ucchimasa/bldc_driver/bldc_driver.kicad_pcb

## KiCad design bldc_driver.kicad_pcb (2026-08-02)

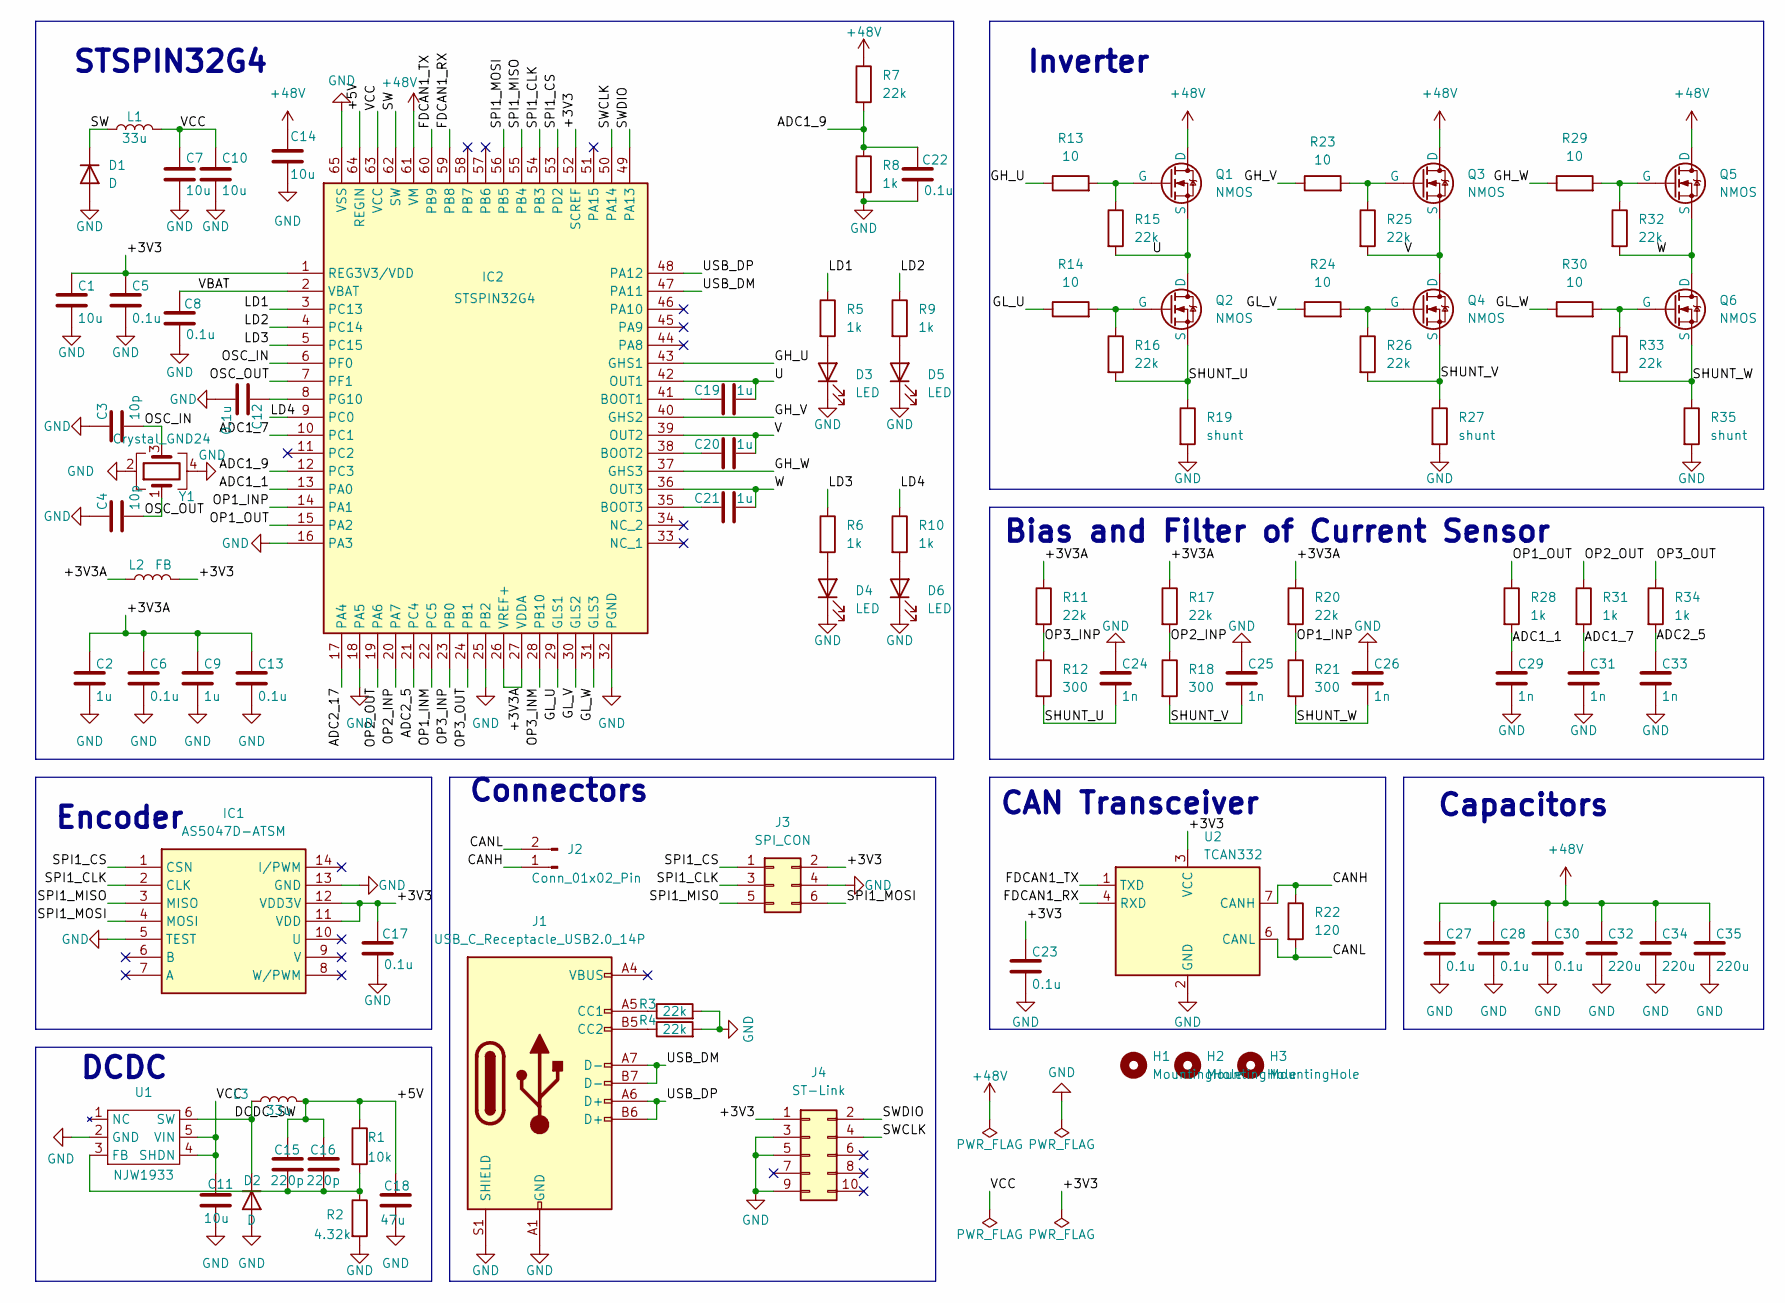
[picture p1: schematic bldc_driver.kicad_sch]

Parts:
C1, C14: 10u; C_1206_3216Metric_Pad1.33x1.80mm_HandSolder
C2, C9, C19, C20, C21: 1u; C_0603_1608Metric_Pad1.08x0.95mm_HandSolder
C3, C4: 10p; C_0603_1608Metric_Pad1.08x0.95mm_HandSolder
C5, C6, C8, C12, C13, C17, C22, C23, C27, C28, C30: 0.1u; C_0603_1608Metric_Pad1.08x0.95mm_HandSolder
C7, C10, C11: 10u; C_0805_2012Metric_Pad1.18x1.45mm_HandSolder
C15, C16: 220p; C_0402_1005Metric_Pad0.74x0.62mm_HandSolder
C18: 47u; C_1210_3225Metric_Pad1.33x2.70mm_HandSolder
C24, C25, C26, C29, C31, C33: 1n; C_0603_1608Metric_Pad1.08x0.95mm_HandSolder
C32, C34, C35: 220u; CP_Elec_10x10
D1, D2: D; RSX101VAM
D3, D4, D5, D6: LED; D_0603_1608Metric_Pad1.05x0.95mm_HandSolder
H1, H2, H3: MountingHole; MountingHole_3.2mm_M3
IC1: AS5047D-ATSM; SOP65P640X120-14N; Mouser Part Number 985-AS5047D-ATSM
IC2: STSPIN32G4; QFN50P900X900X100-65N-D-padlong; Manufacturer_Part_Number STSPIN32G4
J1: USB_C_Receptacle_USB2.0_14P; USB_C_Receptacle_XKB_U262-16XN-4BVC11
J2: Conn_01x02_Pin; PinHeader_1x02_P2.54mm_Vertical
J3: SPI_CON; PinHeader_2x03_P2.54mm_Vertical
J4: ST-Link; PinHeader_2x05_P1.27mm_Vertical_big
L1, L3: 33u; ELL6SH330M
L2: FB; L_0603_1608Metric_Pad1.05x0.95mm_HandSolder
Q1, Q2, Q3, Q4, Q5, Q6: NMOS; SOT8002-1-8
R1: 10k; R_0603_1608Metric_Pad0.98x0.95mm_HandSolder
R2: 4.32k; R_0603_1608Metric_Pad0.98x0.95mm_HandSolder
R3, R4, R7, R11, R15, R16, R17, R20, R25, R26, R32, R33: 22k; R_0603_1608Metric_Pad0.98x0.95mm_HandSolder
R5, R6, R8, R9, R10, R28, R31, R34: 1k; R_0603_1608Metric_Pad0.98x0.95mm_HandSolder
R12, R18, R21: 300; R_0603_1608Metric_Pad0.98x0.95mm_HandSolder
R13, R14, R23, R24, R29, R30: 10; R_0603_1608Metric_Pad0.98x0.95mm_HandSolder
R19, R27, R35: shunt; R_2512_6332Metric_Pad1.40x3.35mm_HandSolder
R22: 120; R_0603_1608Metric_Pad0.98x0.95mm_HandSolder
U1: NJW1933; SOT-23-6-1
U2: TCAN332; SOIC-8_3.9x4.9mm_P1.27mm
Y1: Crystal_GND24; Crystal_SMD_SeikoEpson_FA238V-4Pin_3.2x2.5mm

Connections:
+48V: C14.1, C27.1, C28.1, C30.1, C32.1, C34.1, C35.1, IC2.61 (VM), Q1.1 (D), Q3.1 (D), Q5.1 (D), R7.1
/+3V3: C1.1, C5.1, C17.1, C23.1, IC1.11 (VDD), IC1.12 (VDD3V), IC2.1 (REG3V3/VDD), IC2.52 (SCREF), J3.2, J4.1, L2.2, U2.3 (VCC)
/+3V3A: C2.1, C6.1, C9.1, C13.1, IC2.26 (VREF+), IC2.27 (VDDA), L2.1, R11.1, R17.1, R20.1
/+5V: C15.1, C16.1, C18.1, IC2.64 (REGIN), L3.2, R1.1
/ADC1_1: C29.1, IC2.13 (PA0), R28.2
/ADC1_7: C31.1, IC2.10 (PC1), R31.2
/ADC1_9: C22.1, IC2.12 (PC3), R7.2, R8.1
/ADC2_5: C33.1, IC2.21 (PC4), R34.2
/ADC2_17: IC2.17 (PA4)
/CANH: J2.1, R22.1, U2.7 (CANH)
/CANL: J2.2, R22.2, U2.6 (CANL)
/DCDC_SW: D2.1 (K), L3.1, U1.6 (SW)
/FDCAN1_RX: IC2.59 (PB8), U2.4 (RXD)
/FDCAN1_TX: IC2.60 (PB9), U2.1 (TXD)
/GH_U: IC2.43 (GHS1), R13.1
/GH_V: IC2.40 (GHS2), R23.1
/GH_W: IC2.37 (GHS3), R29.1
/GL_U: IC2.29 (GLS1), R14.1
/GL_V: IC2.30 (GLS2), R24.1
/GL_W: IC2.31 (GLS3), R30.1
/LD1: IC2.3 (PC13), R5.1
/LD2: IC2.4 (PC14), R9.1
/LD3: IC2.5 (PC15), R6.1
/LD4: IC2.9 (PC0), R10.1
/OP1_INM: IC2.22 (PC5)
/OP1_INP: IC2.14 (PA1), R20.2, R21.1
/OP1_OUT: IC2.15 (PA2), R28.1
/OP2_INP: IC2.20 (PA7), R17.2, R18.1
/OP2_OUT: IC2.19 (PA6), R31.1
/OP3_INM: IC2.28 (PB10)
/OP3_INP: IC2.23 (PB0), R11.2, R12.1
/OP3_OUT: IC2.24 (PB1), R34.1
/OSC_IN: C3.2, IC2.6 (PF0), Y1.3
/OSC_OUT: C4.2, IC2.7 (PF1), Y1.1
/SHUNT_U: C24.2, Q2.3 (S), R12.2, R16.2, R19.1
/SHUNT_V: C25.2, Q4.3 (S), R18.2, R26.2, R27.1
/SHUNT_W: C26.2, Q6.3 (S), R21.2, R33.2, R35.1
/SPI1_CLK: IC1.2 (CLK), IC2.54 (PB3), J3.3
/SPI1_CS: IC1.1 (CSN), IC2.53 (PD2), J3.1
/SPI1_MISO: IC1.3 (MISO), IC2.55 (PB4), J3.5
/SPI1_MOSI: IC1.4 (MOSI), IC2.56 (PB5), J3.6
/SW: D1.1 (K), IC2.62 (SW), L1.1
/SWCLK: IC2.50 (PA14), J4.4
/SWDIO: IC2.49 (PA13), J4.2
/U: C19.2, IC2.42 (OUT1), Q1.3 (S), Q2.1 (D), R15.2
/USB_DM: IC2.47 (PA11), J1.A7 (D-), J1.B7 (D-)
/USB_DP: IC2.48 (PA12), J1.A6 (D+), J1.B6 (D+)
/V: C20.2, IC2.39 (OUT2), Q3.3 (S), Q4.1 (D), R25.2
/VBAT: C8.1, IC2.2 (VBAT)
/VCC: C7.1, C10.1, C11.1, IC2.63 (VCC), L1.2, U1.4 (SHDN), U1.5 (VIN)
/W: C21.2, IC2.36 (OUT3), Q5.3 (S), Q6.1 (D), R32.2
GND: C1.2, C2.2, C3.1, C4.1, C5.2, C6.2, C7.2, C8.2, C9.2, C10.2, C11.2, C12.2, C13.2, C14.2, C17.2, C18.2, C22.2, C23.2, C24.1, C25.1, C26.1, C27.2, C28.2, C29.2, C30.2, C31.2, C32.2, C33.2, C34.2, C35.2, D1.2 (A), D2.2 (A), D3.1 (K), D4.1 (K), D5.1 (K), D6.1 (K), IC1.5 (TEST), IC1.13 (GND), IC2.16 (PA3), IC2.18 (PA5), IC2.25 (PB2), IC2.32 (PGND), IC2.65 (VSS), J1.A1 (GND), J1.A12 (GND), J1.B1 (GND), J1.B12 (GND), J1.S1 (SHIELD), J3.4, J4.3, J4.5, J4.9, R2.2, R3.2, R4.2, R8.2, R19.2, R27.2, R35.2, U1.2 (GND), U2.2 (GND), Y1.2, Y1.4
unnamed: D3.2 (A), R5.2
unnamed: D4.2 (A), R6.2
unnamed: D5.2 (A), R9.2
unnamed: D6.2 (A), R10.2
unnamed: C19.1, IC2.41 (BOOT1)
unnamed: C20.1, IC2.38 (BOOT2)
unnamed: C21.1, IC2.35 (BOOT3)
unnamed: C12.1, IC2.8 (PG10)
unnamed: J1.A5 (CC1), R3.1
unnamed: J1.B5 (CC2), R4.1
unnamed: Q1.2 (G), R13.2, R15.1
unnamed: Q2.2 (G), R14.2, R16.1
unnamed: Q3.2 (G), R23.2, R25.1
unnamed: Q4.2 (G), R24.2, R26.1
unnamed: Q5.2 (G), R29.2, R32.1
unnamed: Q6.2 (G), R30.2, R33.1
unnamed: C15.2, C16.2, R1.2, R2.1, U1.3 (FB)

Notes on the sheet:
Inverter
CAN Transceiver
Bias and Filter of Current Sensor
STSPIN32G4
DCDC
Encoder
Connectors
Capacitors

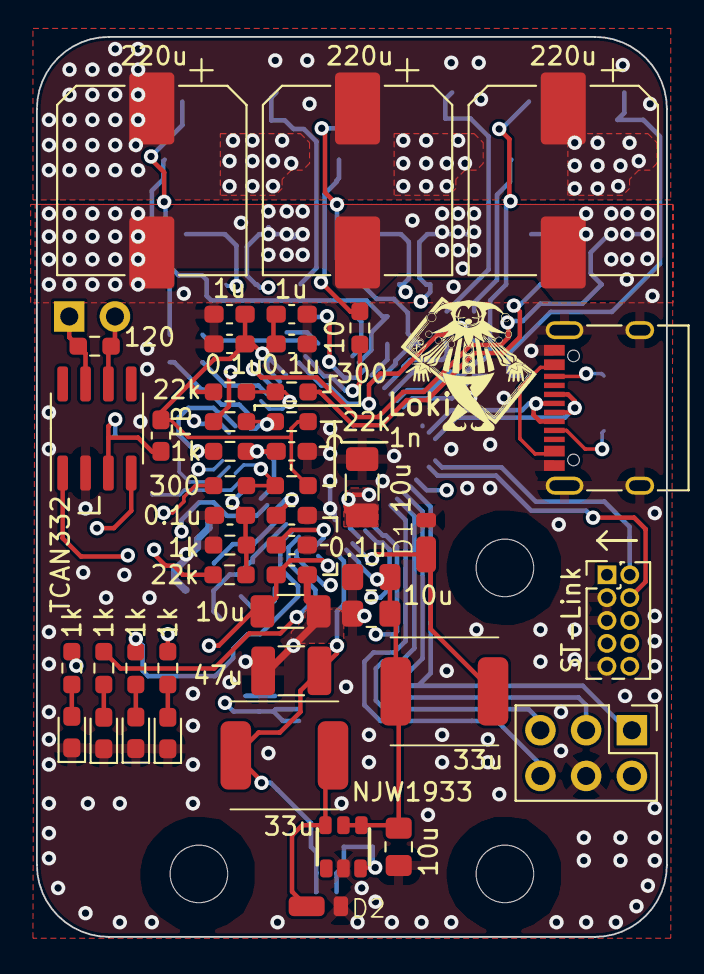
[picture p2: board bldc_driver.kicad_pcb from above]

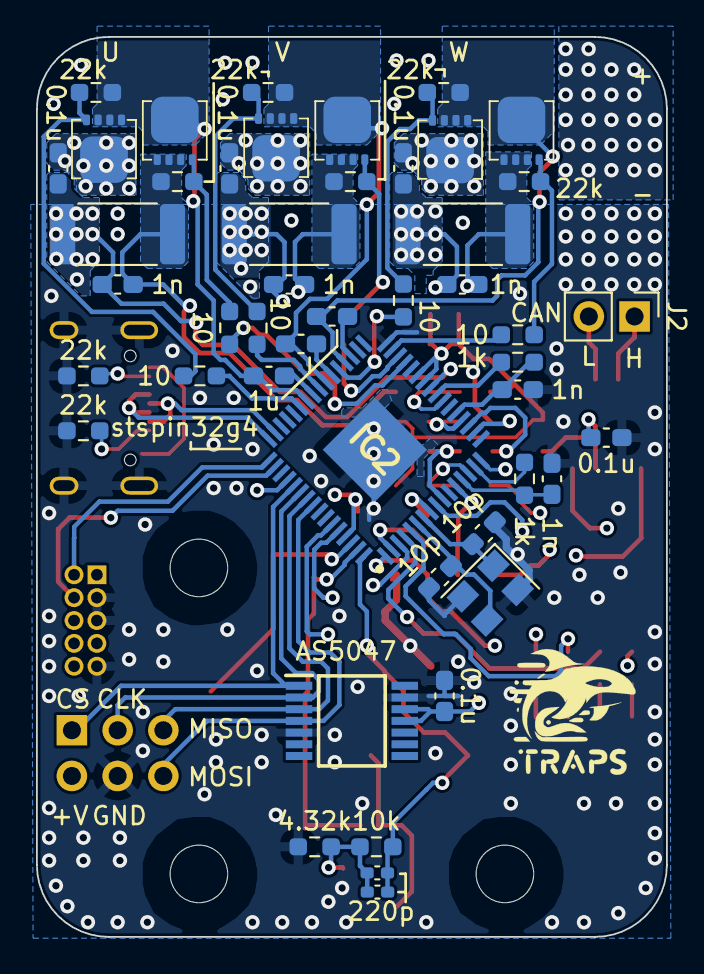
[picture p3: board bldc_driver.kicad_pcb from below]

Board: 4 copper layers, 35.0 x 50.0 mm, 97 parts (47 on the bottom side), 66 nets.
