ucchimasa/bldc_driver/(commit log)

2024-11-24 回路図描いた
    [bldc_driver.kicad_pcb, bldc_driver.kicad_sch]
2024-11-26 フットプリント割り当て中
    [bldc_driver.kicad_sch]
2024-11-28 割り当て終了+gitignore追加
    [bldc_driver.kicad_pcb, bldc_driver.kicad_sch]
2024-12-01 なんとなく配線できてきた
    [bldc_driver.kicad_pcb, bldc_driver.kicad_sch]
2024-12-02 配線がほとんど終わった
    [bldc_driver.kicad_pcb, bldc_driver.kicad_sch]
2024-12-09 ガーバー吐いた
    [bldc_driver.kicad_pcb, bldc_driver.kicad_sch]
2024-12-09 値及びフットプリント修正
    [bldc_driver.kicad_pcb, bldc_driver.kicad_sch]
2026-07-26 QDD用に修正開始
    [bldc_driver.kicad_pcb, bldc_driver.kicad_sch]
2026-08-01 修正完了
    [bldc_driver.kicad_pcb, bldc_driver.kicad_sch]
2026-08-02 gerber出力
    [bldc_driver.kicad_pcb]
